ea3igt/HL2-PA70/Images/HL2 to PA70 connection v1.0.JPG

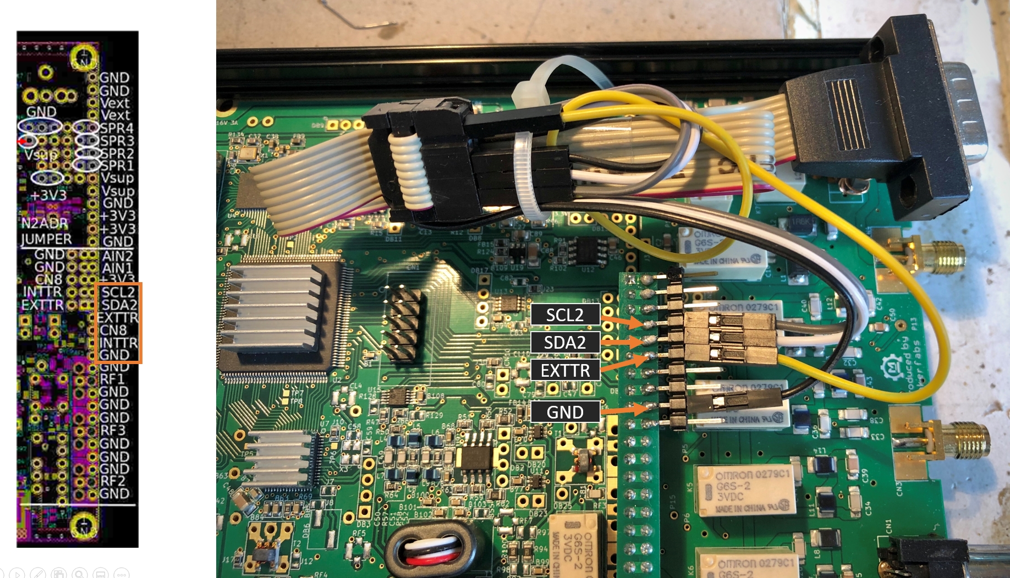
Images/HL2 to PA70 connection v1.0.JPG
