ea3igt/HL2-PA70/Images/MRF9120.JPG

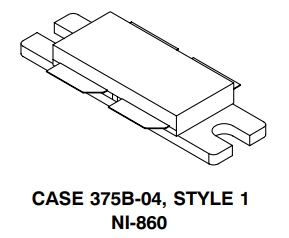
Images/MRF9120.JPG
