ea3igt/HL2-PA70/Software/Background.jpg

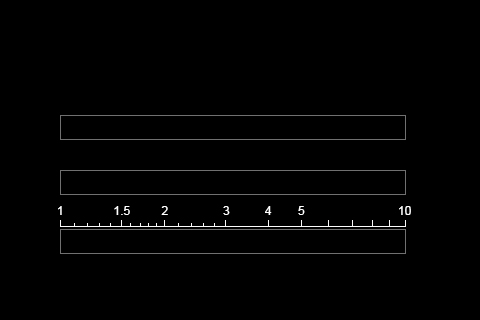
Software/Background.jpg
