ea3igt/HL2-PA70/PCB Board/Control Board v2.1 BOM.xlsx

Ref | Value | Description | Part
J1 | 6V | Generic screw terminal, single row, 01x02 | https://www.mouser.es/ProductDetail/504-EM366002
P1 | Digital | Socket_Arduino_Nano:Generic connector, single row, 01x15:Socket_Strip_Arduino_1x15
P2 | Analog | Socket_Arduino_Nano:Generic connector, single row, 01x15:Socket_Strip_Arduino_1x15
P3 | LPF | Generic connector, single row, 01x08:Connector_PinHeader_2.54mm:PinHeader_1x08_P2.54mm_Vertical
P4 | PTT | Generic connector, single row, 01x01:Connector_PinHeader_2.54mm:PinHeader_1x01_P2.54mm_Vertical
P5 | RS232 | Generic connector, double row, 02x05:PinHeader_2x05_P2.54mm_Vertical
P6 | OLED | Generic connector, single row, 01x04:PinHeader_1x04_P2.54mm_Vertical
P7 | PWM | Generic connector, single row, 01x01:PinHeader_1x01_P2.54mm_Vertical
P8 | NTC | Generic connector, single row, 01x02:PinHeader_1x02_P2.54mm_Vertical
P9 | RESET | Generic connector, single row, 01x02:PinHeader_1x02_P2.54mm_Vertical
C1,C2,C3 | 100nF | Capacitor_SMD:C_1812_4532Metric_Pad1.30x3.40mm_HandSolder | https://www.mouser.es/ProductDetail/80-C1812C104J5R
IC1,IC2 | MMPQ2222A | Package_SO:SOIC-16_3.9x9.9mm_P1.27mm | https://www.mouser.es/ProductDetail/512-MMPQ2222A
Q1 | 2N3904 | 0.2A Ic, 40V Vce, Small Signal NPN Transistor, TO-92 | https://www.mouser.es/ProductDetail/511-2N3904
R1..R8 | 1K | Resistor_SMD:R_2010_5025Metric_Pad1.52x2.65mm_HandSolder | https://www.mouser.es/ProductDetail/652-CMP2010-FX-1001L
R10,R11,R12 | 1K | Resistor_SMD:R_2010_5025Metric_Pad1.52x2.65mm_HandSolder | https://www.mouser.es/ProductDetail/652-CMP2010-FX-1001L
R9 | 10K | Resistor_SMD:R_2010_5025Metric_Pad1.52x2.65mm_HandSolder | https://www.mouser.es/ProductDetail/652-CMP2010-FX-1002L
