ea3igt/HL2-PA70/(threads)

Thread 2 (2024-01-22):

MMPQ2222A availability

leifj, 2024-01-22:
the MMPQ2222A is pretty much unobtainium now. I tried to do a jlcpcb run and those quad arrays don't seem to exist. A quick equivalence search on Farnell turn up the [MMPQ3904](https://ie.farnell.com/on-semiconductor/mmpq3904/trans-bipol-npn-quad-40v-soic/dp/2454040) but those have slightly different specs.

1. Would the MMPQ3904 likely work?
2. Is there an alternative component?

ea3igt, 2024-01-23:
Any generic NPN transistor will do the job, as it works as a switch, driving the signal to ground. I think this MMPQ3904 will work

Closed 2024-02-24.

Thread 3 (2025-03-16):

Nextion File will not load into Nextion Editor V1.67.1

makidoja, 2025-03-16:
Hi

I'm looking to build your amplifier using the Arduino and TFT but the file for the Nextion doesn;t seem to load into the software V1.67.1

Could you please check the file?

Jim M0CKE

makidoja, 2025-03-16:
Managed to get it to load

Closed 2025-03-16.
